tomas-altamiranot/magnetic-field-mapper/docs/build/05-electronics-enclosure.png

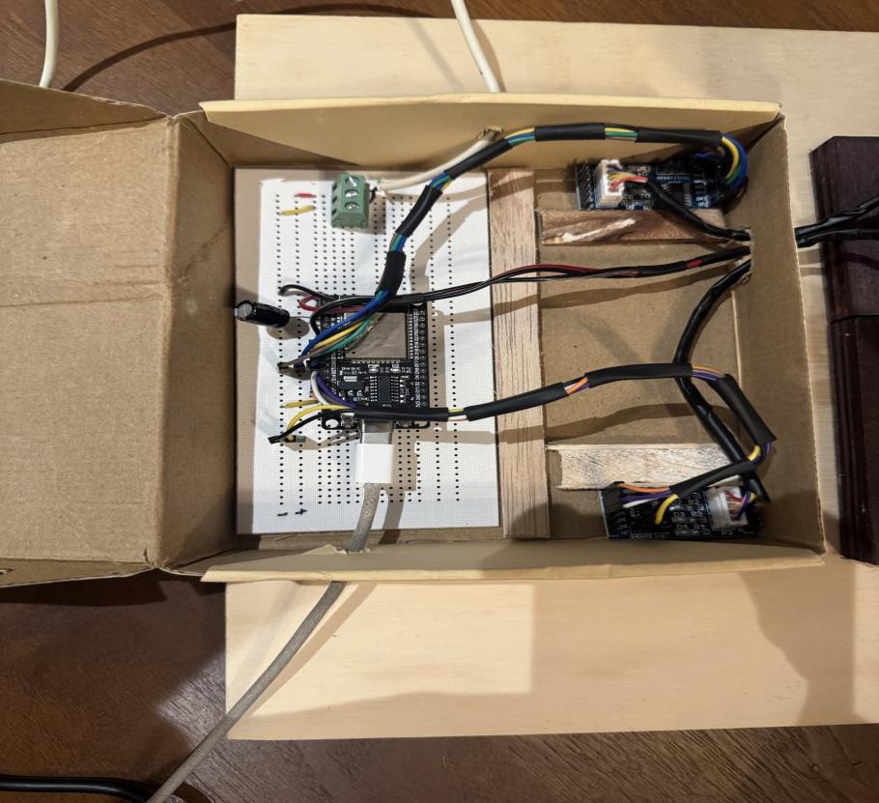
docs/build/05-electronics-enclosure.png
