tomas-altamiranot/magnetic-field-mapper/docs/build/03-rack-pinion-mounted.png

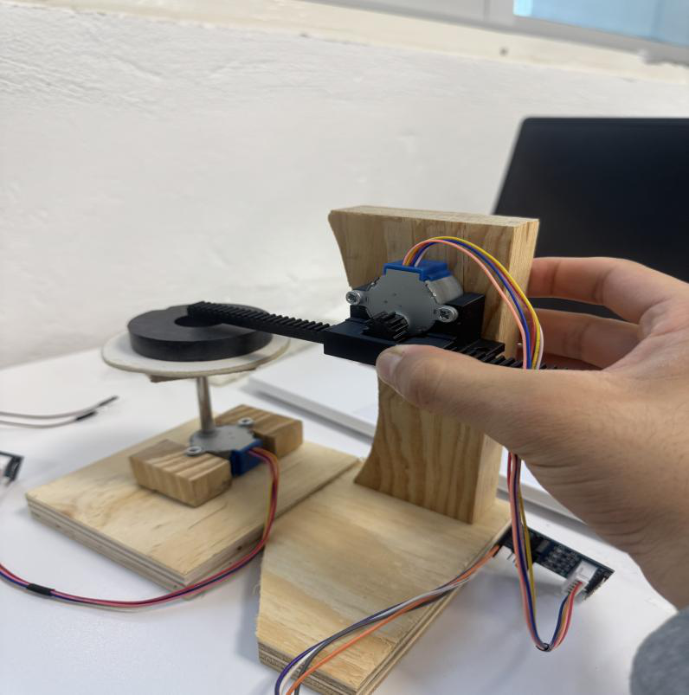
docs/build/03-rack-pinion-mounted.png
