tomas-altamiranot/magnetic-field-mapper/(commit log)

2026-08-11 2D magnetic field mapper: firmware, analysis pipeline, dataset and documentation
    ESP32 firmware drives a two-axis polar scan (72 angular x 18 radial positions)
    sampling an SS49E Hall sensor; a Python pipeline captures the serial stream,
    converts polar to cartesian and renders an interpolated heatmap.
    Includes the 1,296-point dataset from the final run, hardware photos, and the
    scan history documenting how breadboard false contacts were diagnosed and fixed.
    [datos_campo_magnetico.csv]
2026-08-11 Código real de Arduino IDE actualizado...
2026-08-12 Align docs with the actual firmware behaviour
    The README described auto-homing after FIN, which the real firmware does not do:
    it halts and requires manual recentring plus a board reset. Corrects that, updates
    VALOR_ZERO to 1936, documents the 0.04884 mT measurement lattice with a snippet to
    verify it against the dataset, and notes manual centring as the main source of
    run-to-run variation.
    [escaner_campo_magnetico.ino]
